tzahroof/teachable_grasping_device/Report/brainstorming.pdf

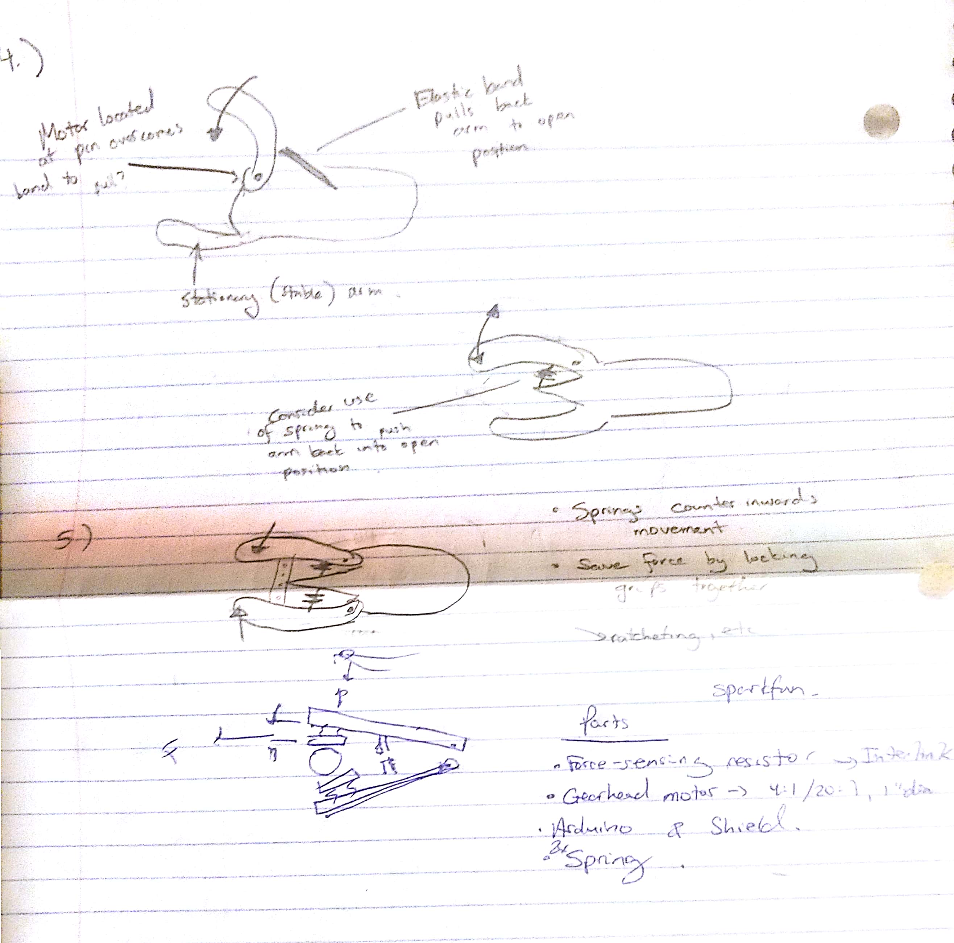
[picture p8: page 2]
