tzahroof/teachable_grasping_device/Report/quad.png

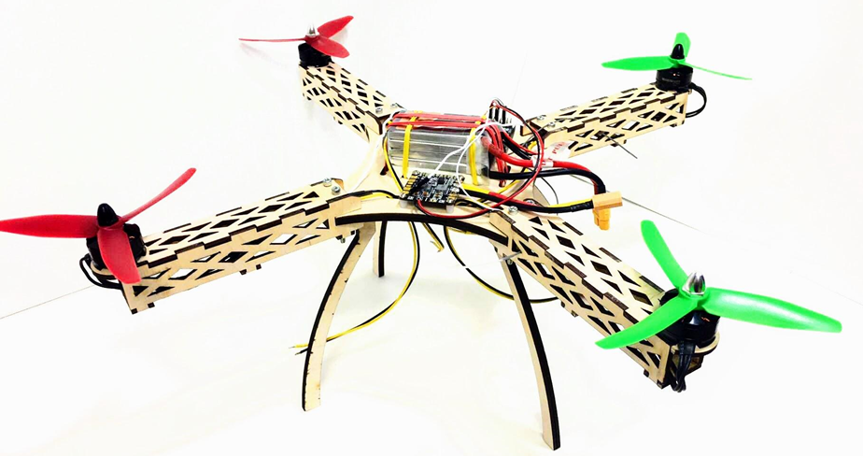
Report/quad.png
